AndreasExner/iobroker-IoT-WindSensor/(commit log)

2020-12-07 Update WindSensor.ino
    Bugfix sensor activation
    [WindSensor.ino]
2020-12-07 Update AEX_iobroker_IoT_Framework.ino
    bugfix sensor activation
    [AEX_iobroker_IoT_Framework.ino]
2020-12-14 Important bugfix
    - fixed: sketch does not work with debug=false
    - added CRC check for UART/RS485
    - changed wind speed data transfer (for de-noising)
    - minor fixes and improvements
    [WindSensor.ino]
2020-12-21 Major improvements and bugfixes for the UART/RS485 communication
    - Major bugfix: sketch does not work with debug=false
    - Major improvements and bugfixes for the UART/RS485 communication: CRC check, remove zero bytes etc
    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
    [WindSensor.ino]
2020-12-21 Major improvements and bugfixes for the UART/RS485 communication
    [AEX_iobroker_IoT_Framework.ino]
